Melly1971/Pioneer-AVIC-F940BT-IR-decoder/ATTiny45 IR NEC.pdf

+5V

+5V

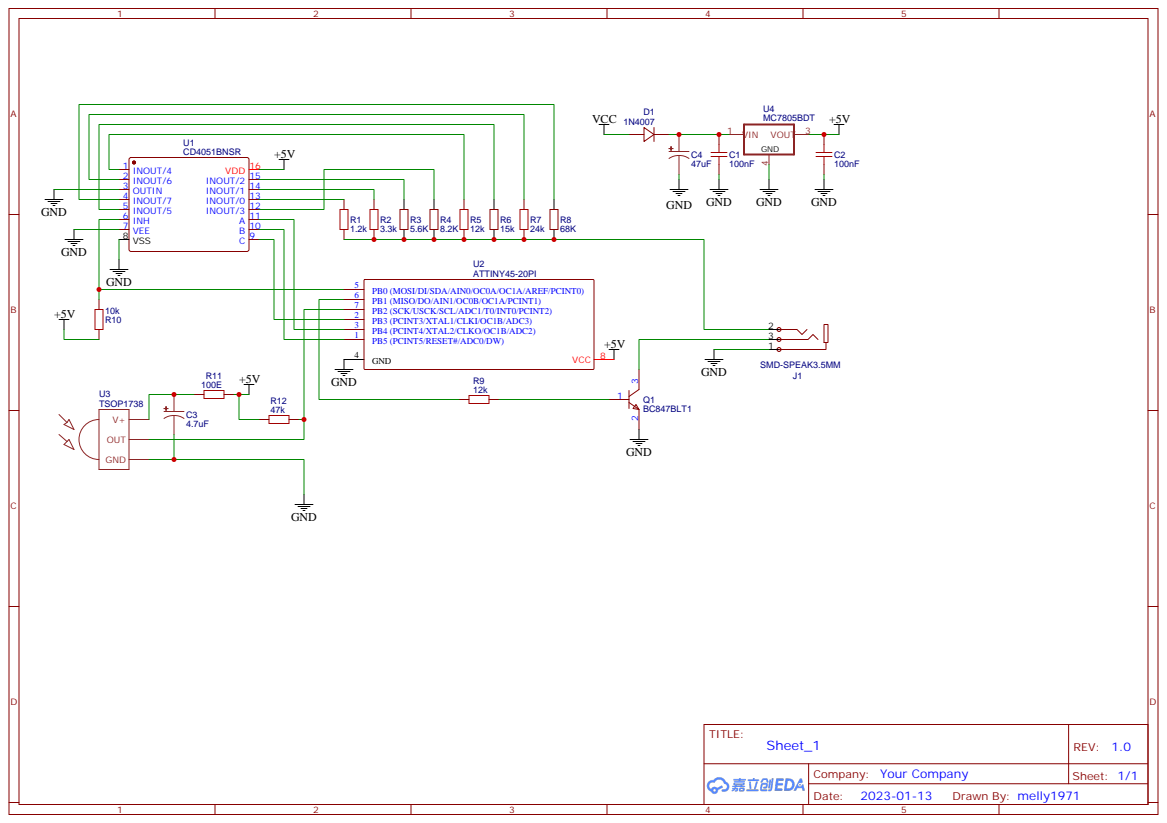
[picture p1: page 1]
