Melly1971/Pioneer-AVIC-F940BT-IR-decoder/ATTiny2313 IR NEC decoder for Pioneer AVIC.pdf

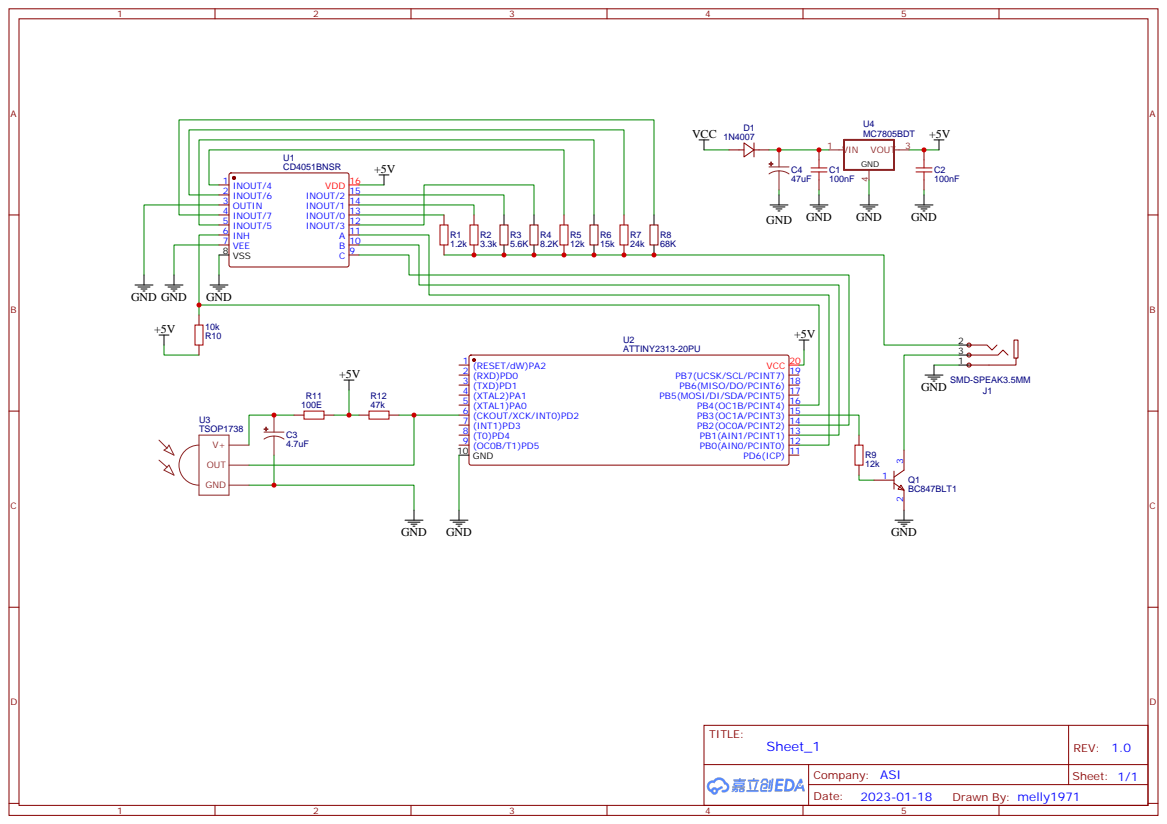
[picture p2: page 1]
